motthomasn/K-Line_Logger/Images/5V_Rise_Time_Check.png

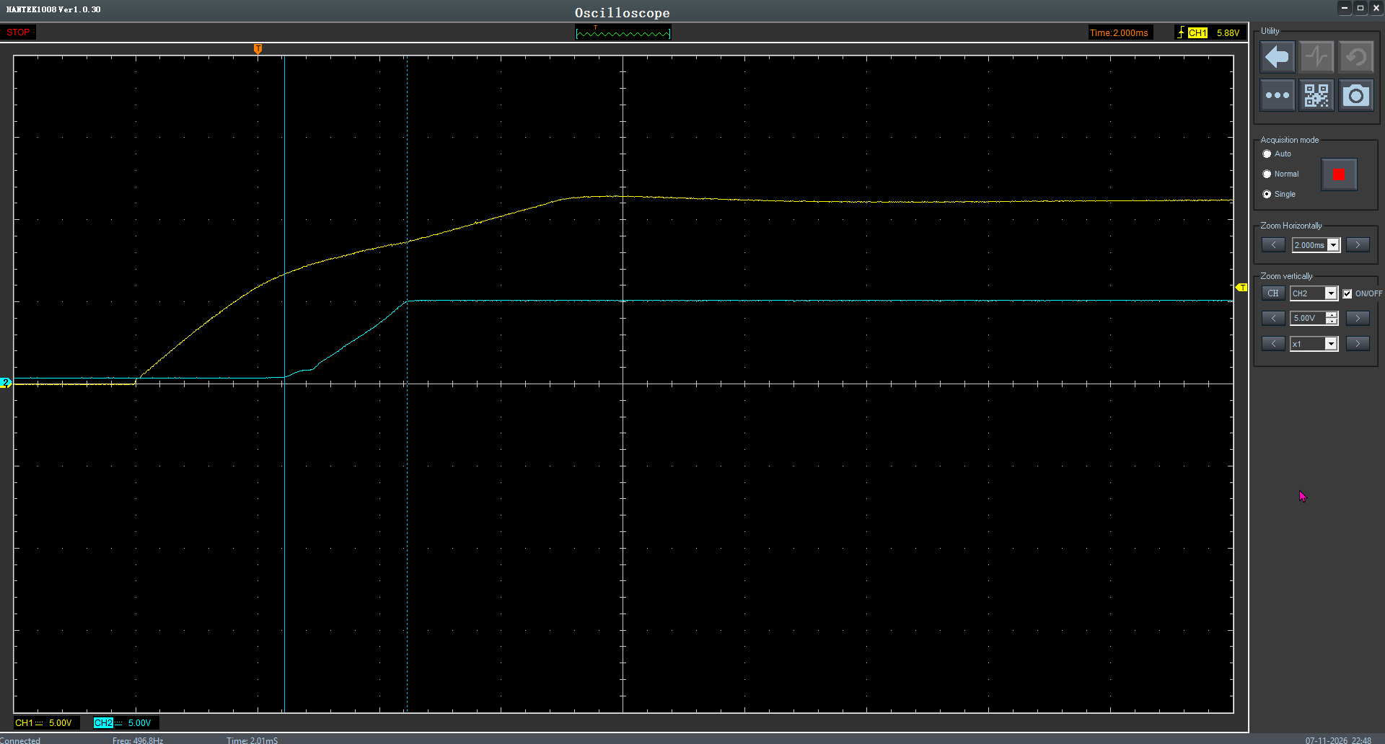
Images/5V_Rise_Time_Check.png
