motthomasn/K-Line_Logger/Images/Bottom_CAD_Image.png

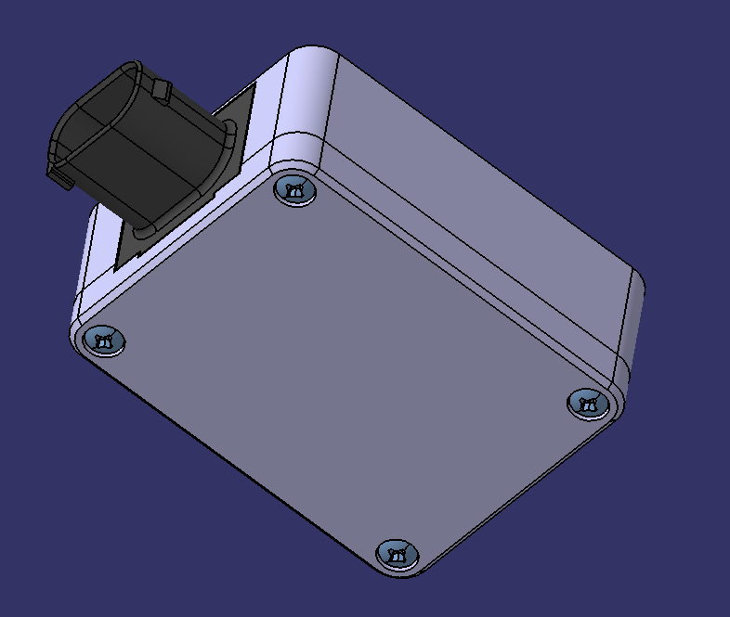
Images/Bottom_CAD_Image.png
