motthomasn/K-Line_Logger/Images/Front_CAD_Image.png

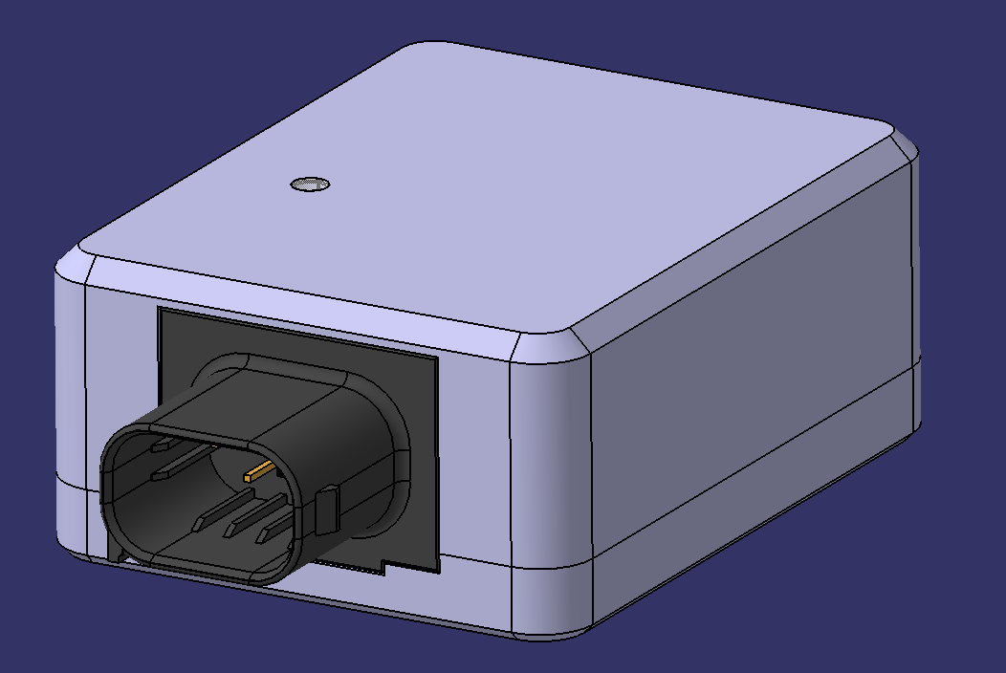
Images/Front_CAD_Image.png
