motthomasn/K-Line_Logger/Images/Logger_Bottom.jpg

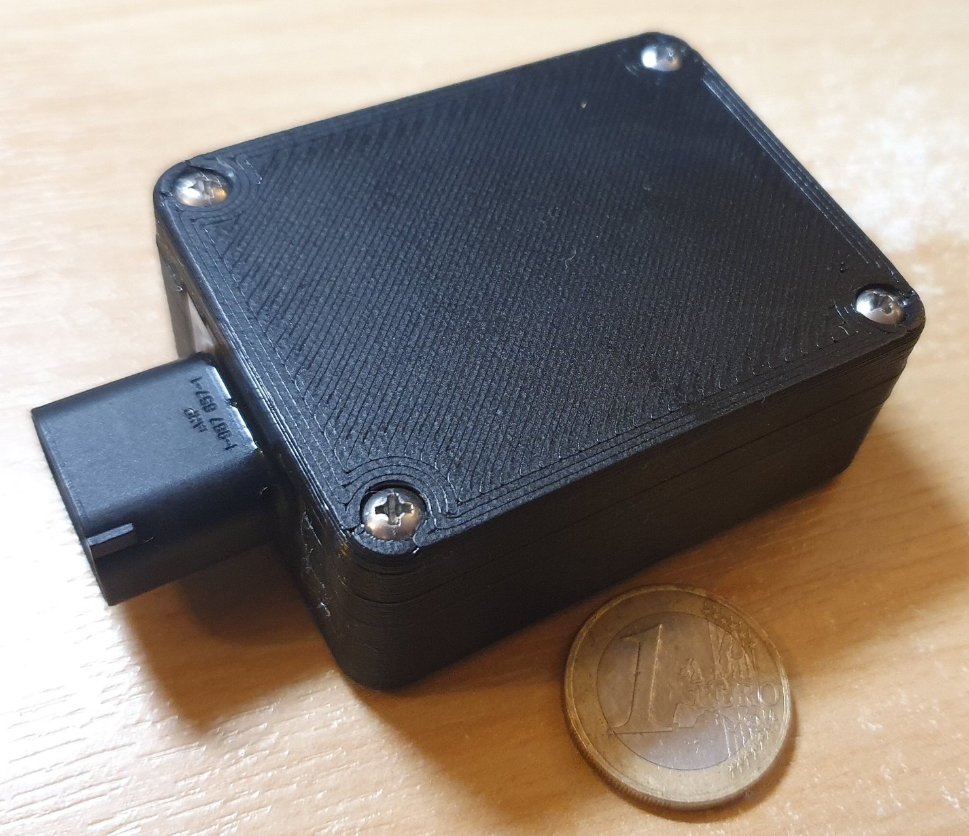
Images/Logger_Bottom.jpg
