motthomasn/K-Line_Logger/Hardware/Kline_SD_Logger_PCB/Kline_SD_Logger_PCB.csv

Reference | Qty | Value | Description | MPN | Farnell SPN | Manufacturer
BT1 | 1 | 3001 | CR1220, CR1216 Coin Cell Retainer | 3001 |  | Keystone
C1 | 1 | 22µF, 25V | SMD Multilayer Ceramic Capacitor, 22 µF, 25 V, 0805 \[2012 Metric], ± 20%, X5R | GRM21BR61E226ME44K | 3790439 | Murata
C2 | 1 | 22,000µF | Supercapacitor, EDLC, 22000 µF, 5.5 V, Radial Leaded, -20%, +80%, 5 mm, 1000 hours @ 70°C | FM0H223ZF | 2777877 | Kemet
C3 | 1 | 5nF, 50V | CAP, MLCC, X7R, 5000PF, 50V, 0805 | 08055C502KAT2A | 3359766 | KYOCERA AVX
D1 | 1 | 40V, 1A | Schottky Rectifier, 40 V, 1 A, Single, SOD-123P, 2 Pins, 560 mV | XBS104P11R-G | 3534762 | TOREX
D2,D3 | 2 | TVS_27V | TVS Diode, SMBJ Series, Unidirectional, 20 V, 32.4 V, DO-214AA (SMB), 2 Pins | SMBJ20A/TR7 | 3104007 | YAGEO
D4 | 1 | G_2.2V_20mA | LED, Low Power, Green, SMD, 1206 (3216 Metric), 20 mA, 2.2 V, 568 nm | KPT-3216SGC | 2099247 | KINGBRIGHT
J1 | 1 | DM3CS-SF | Memory Card Connector, MicroSD, Hinged, 8 Contacts, Copper Alloy, Gold Plated Contacts, DM3 | DM3CS-SF | 1764376 | Hirose
J2 | 1 | TE_1-967657-1 | Rectangular Power Connector, 4 Contacts, MQS, PCB Mount, Through Hole, 3.1 mm, Header | 1-967657-1 | 2798121 | TE Connectivity
R1 | 1 | 3.9K | Thick Film SMD resistor. 3.9K, 1%, 0.13W. 0805 package | CRG0805F3K9 |  | TE Connectivity
R2,R3,R4,R5 | 4 | 523 | Metal Film SMD resistor. 523, 0.1%, 0.13W. 0805 package | ERA6AEB5230V |  | Panasonic
R6 | 1 | 56 | SMD Chip Resistor, 56 ohm, ± 1%, 125 mW, 0805 \[2012 Metric], Thick Film, General Purpose | MCWR08X56R0FTL | 2447689 | MULTICOMP PRO
U1 | 1 | ESP32-C3_SUPERMINI
U2 | 1 | TSR-1-2450 | Switching Regulator, 5VDC Output, 1A | TSR 1-2450 |  | Traco Power
U3 | 1 | L9637 | K-Line I/O Controller Interface IC ISO 9141 Interface | E-L9637D013TR | 3130050 | STMicroelectronics
U4 | 1 | DS3231M | Extremely Accurate I2C-Integrated RTC/TCXO/Crystal SOIC-16
