motthomasn/K-Line_Logger/Hardware/Enclosure/Kline_SD_Logger_Enclosure_Upper.stp

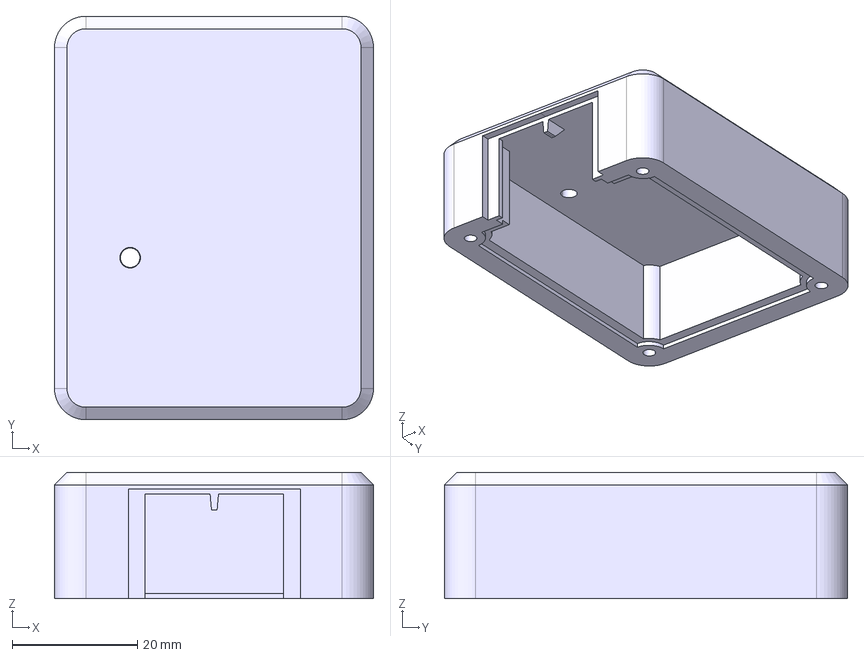
[picture p6: CAD file, 2026-11-08]
Hardware/Enclosure/Kline_SD_Logger_Enclosure_Upper.stp
51.0 x 64.5 x 20.2 mm
