motthomasn/K-Line_Logger/Hardware/Kline_SD_Logger_PCB/Kline_SD_Logger_PCB.step

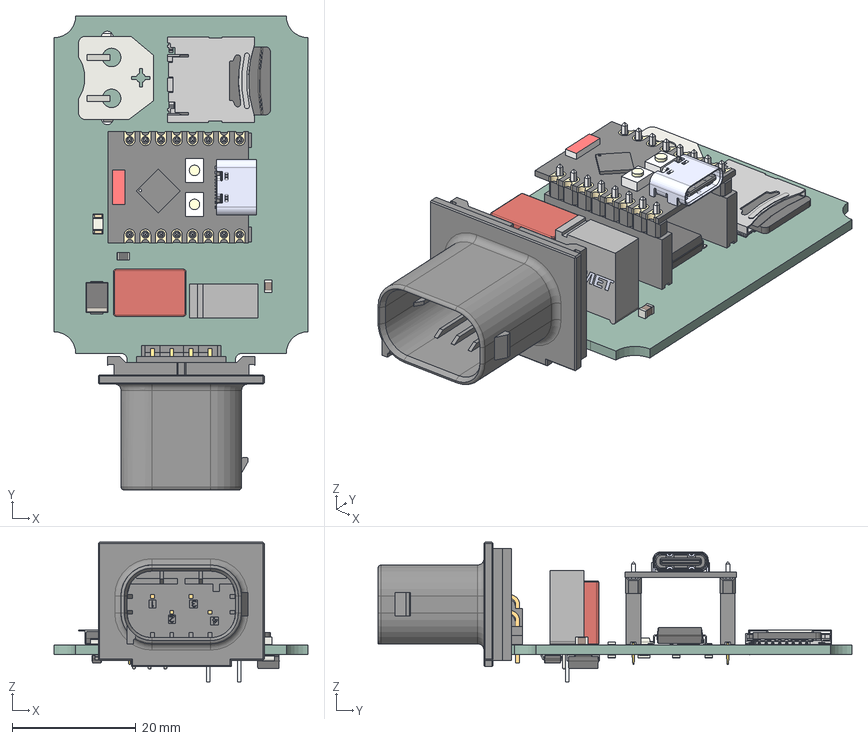
[picture p7: CAD file, 2026-10-16]
Hardware/Kline_SD_Logger_PCB/Kline_SD_Logger_PCB.step
41.0 x 76.6 x 22.6 mm
C_0805_2012Metric x 2
ESP32-C3_SUPERMINI_TH
FM0H223ZF
TE_MQS_4-WAY_1-967657-1
D_SMB x 2
HIROSE_DM3CS-SF
BatteryHolder_Keystone_3001_1x12mm
SOIC-8_3.9x4.9mm_P1.27mm
LED_1206_3216Metric
SOIC-16W_7.5x10.3mm_P1.27mm
Converter_DCDC_TRACO_TSR-1_THT
R_0805_2012Metric x 6
D_SOD-123
Kline_SD_Logger_PCB_PCB
