motthomasn/K-Line_Logger/Hardware/Enclosure/Kline_SD_Logger_Enclosure_Lower.stp

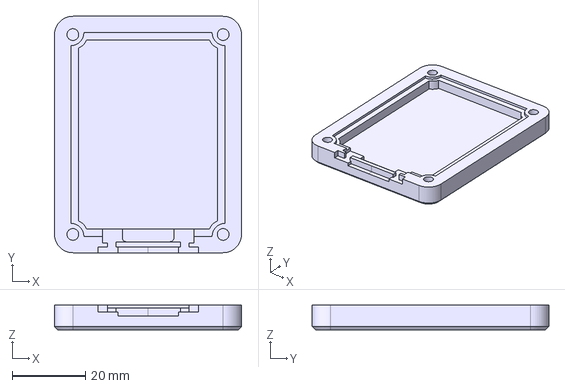
[picture p8: CAD file, 2026-11-08]
Hardware/Enclosure/Kline_SD_Logger_Enclosure_Lower.stp
51.0 x 64.5 x 6.80 mm
