motthomasn/K-Line_Logger/Hardware/Assembly/Adapter_Harness_Suzuki.pdf

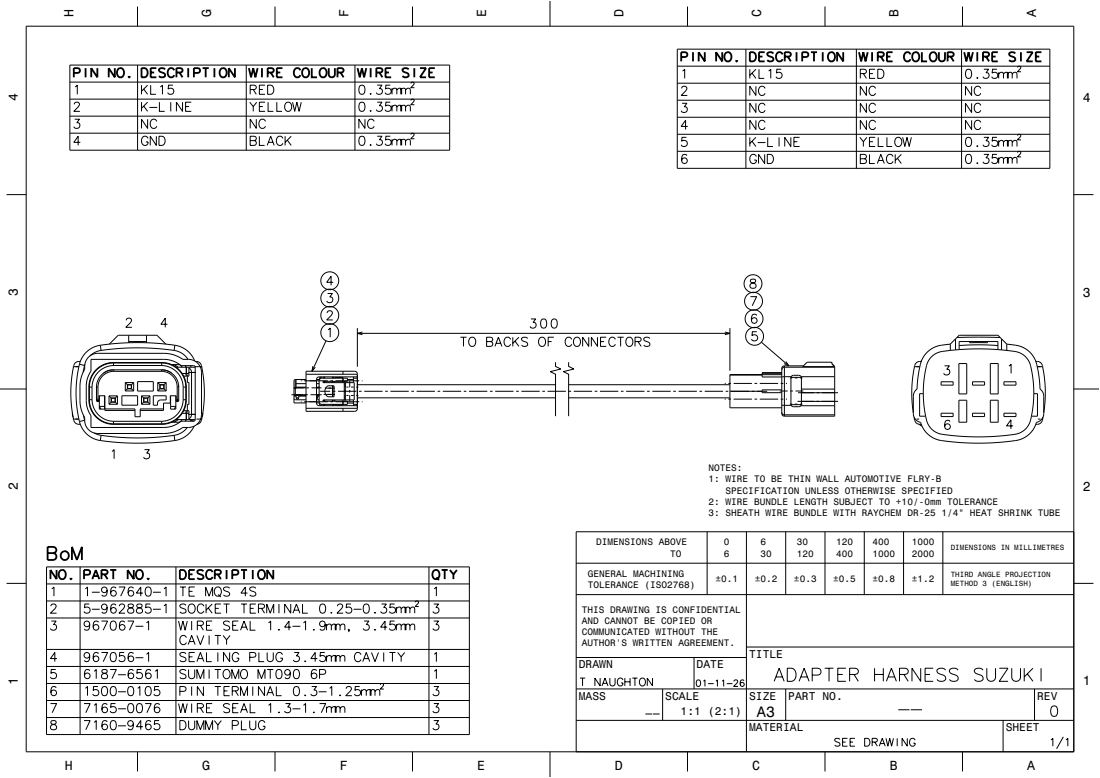
[picture p9: page 1]

NOTES:
1: WIRE TO BE THIN WALL AUTOMOTIVE FLRY-B
SPECIFICATION UNLESS OTHERWISE SPECIFIED
2: WIRE BUNDLE LENGTH SUBJECT TO +10/-0mm TOLERANCE
3: SHEATH WIRE BUNDLE WITH RAYCHEM DR-25 1/4" HEAT SHRINK TUBE

DIMENSIONS ABOVE TO | 0 6 | 6 30 | 30 120 | 120 400 | 400 1000 | 1000 2000 | DIMENSIONS IN MILLIMETRES

GENERAL MACHINING TOLERANCE (ISO2768) | ±0.1 | ±0.2 | ±0.3 | ±0.5 | ±0.8 | ±1.2 | THIRD ANGLE PROJECTION METHOD 3 (ENGLISH)

THIS DRAWING IS CONFIDENTIAL AND CANNOT BE COPIED OR COMMUNICATED WITHOUT THE AUTHOR'S WRITTEN AGREEMENT.

DRAWN | DATE

MASS | SCALE 1:1 (2:1) | SIZE A3 | PART NO. | REV

MATERIAL | SHEET
