motthomasn/K-Line_Logger/Hardware/Assembly/Kline_SD_Logger_Assy.pdf

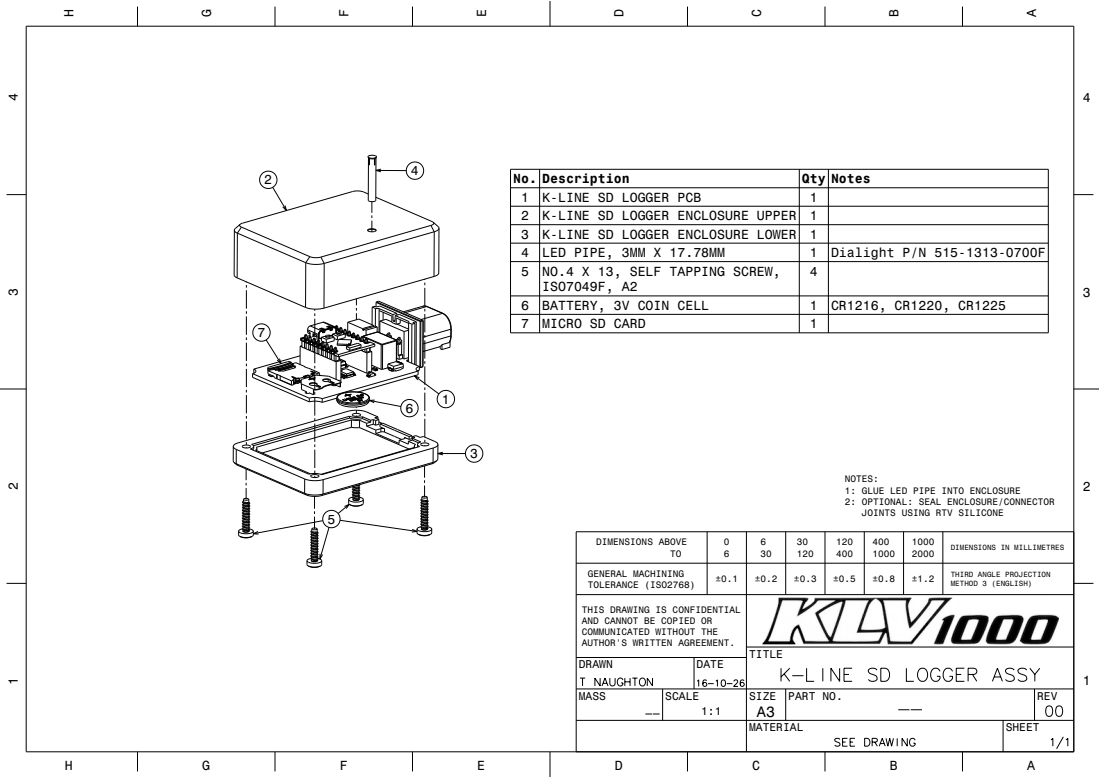
[picture p10: page 1]

No. | Description | Qty | Notes
1 | K-LINE SD LOGGER PCB | 1
2 | K-LINE SD LOGGER ENCLOSURE UPPER | 1
3 | K-LINE SD LOGGER ENCLOSURE LOWER | 1
4 | LED PIPE, 3MM X 17.78MM | 1 | Dialight P/N 515-1313-0700F
5 | NO.4 X 13, SELF TAPPING SCREW, ISO7049F, A2 | 4

6 | BATTERY, 3V COIN CELL | 1 | CR1216, CR1220, CR1225
7 | MICRO SD CARD | 1

NOTES:
1: GLUE LED PIPE INTO ENCLOSURE
2: OPTIONAL: SEAL ENCLOSURE/CONNECTOR
JOINTS USING RTV SILICONE

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

THIS DRAWING IS CONFIDENTIAL AND CANNOT BE COPIED OR COMMUNICATED WITHOUT THE AUTHOR'S WRITTEN AGREEMENT.

DRAWN | DATE

MASS | SCALE 1:1 | SIZE A3 | PART NO. | REV

MATERIAL | SHEET
