motthomasn/K-Line_Logger/Images/Assembled_Board_Bottom.jpg

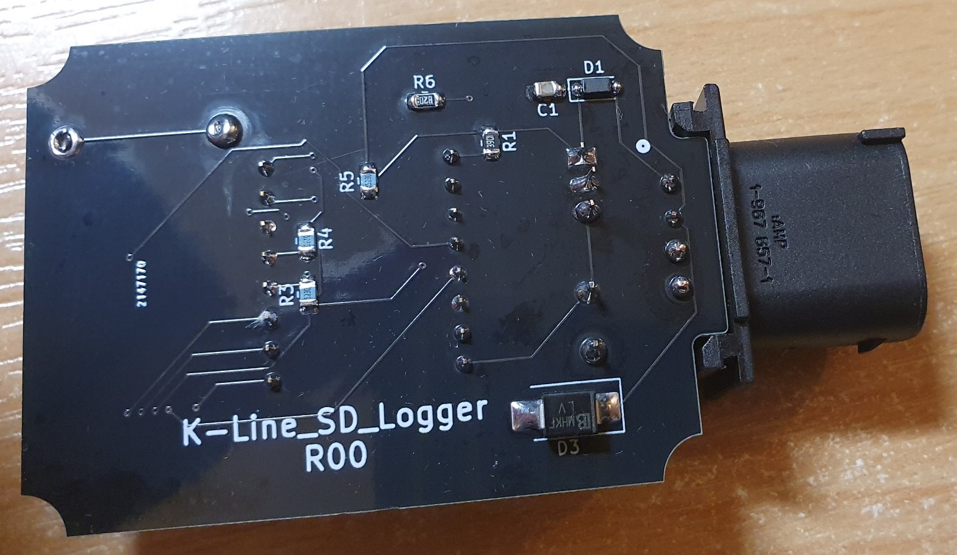
Images/Assembled_Board_Bottom.jpg
