motthomasn/K-Line_Logger/Images/Assembled_Board_CAD_Image.png

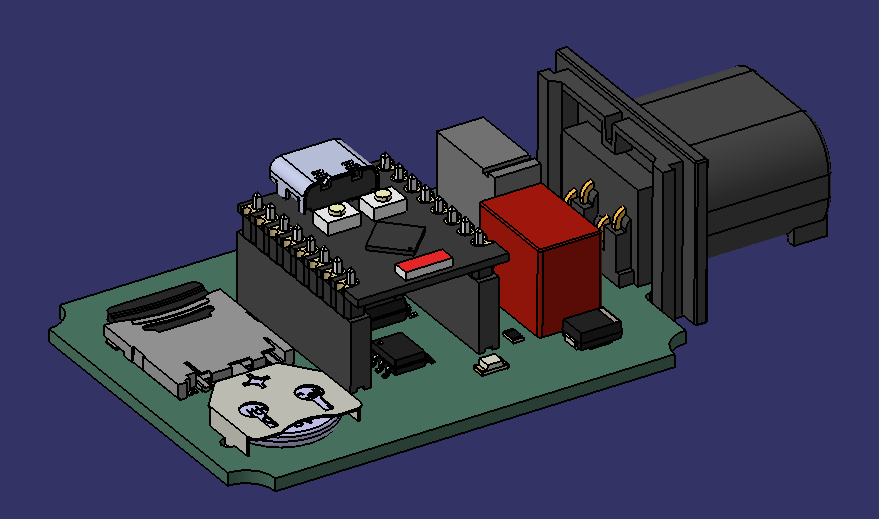
Images/Assembled_Board_CAD_Image.png
