motthomasn/K-Line_Logger/Images/Assembled_Board_Top.jpg

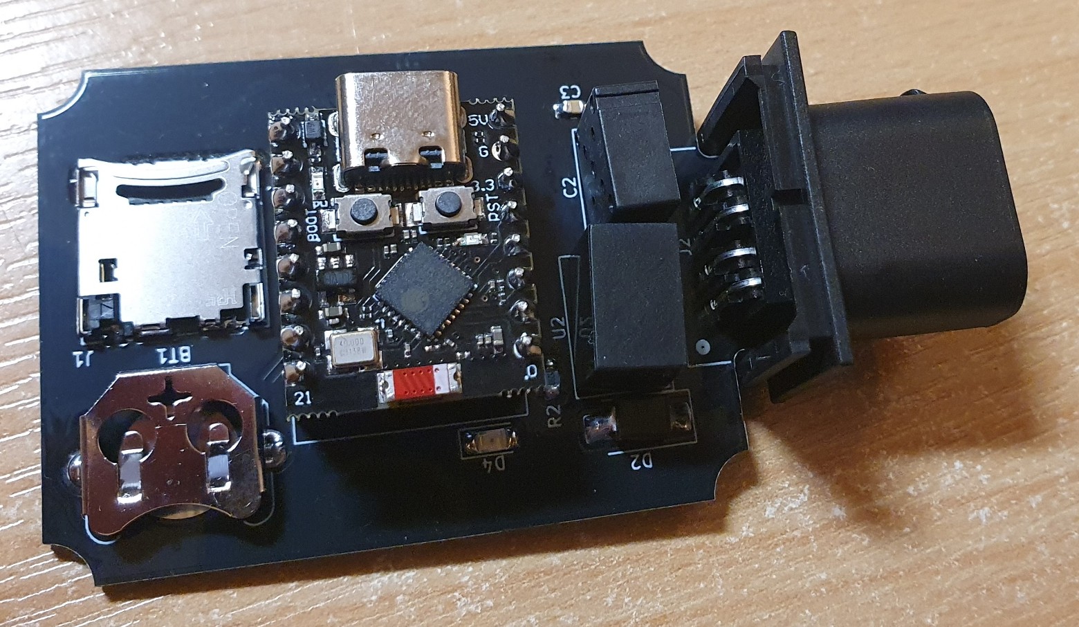
Images/Assembled_Board_Top.jpg
