motthomasn/K-Line_Logger/Images/Exploded_Assembly.png

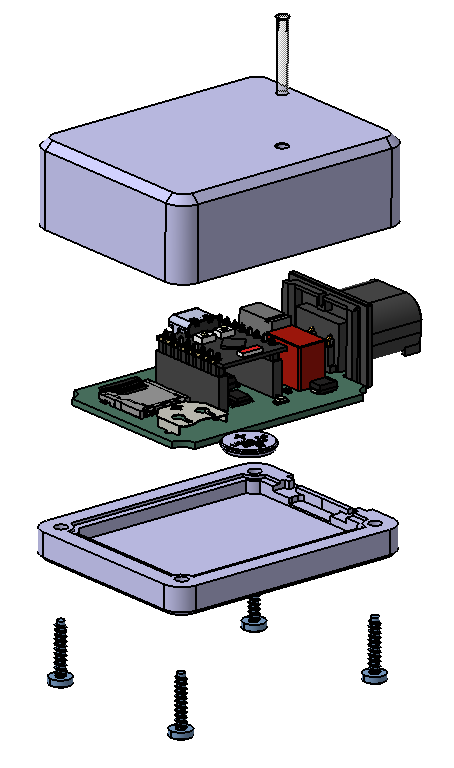
Images/Exploded_Assembly.png
