motthomasn/K-Line_Logger/(commit log)

2026-09-01 Added KiCad PCB design files
    [Kline_SD_Logger_PCB.kicad_pcb, Kline_SD_Logger_PCB.kicad_sch]
2026-09-01 Add initial BoM export
    [Kline_SD_Logger_PCB.csv]
2026-09-02 Add supplier & stock numbers to BoM
    [Kline_SD_Logger_PCB.csv]
2026-09-02 Assign footprints
    [Kline_SD_Logger_PCB.kicad_sch]
2026-10-15 Finalised schematic, updated BoM & placed footprints
    [Kline_SD_Logger_PCB.csv, Kline_SD_Logger_PCB.kicad_pcb, Kline_SD_Logger_PCB.kicad_sch, Kline_SD_Logger_PCB.step]
2026-10-16 Update board edge cuts to fit enclosure
    [Kline_SD_Logger_PCB.kicad_pcb, Kline_SD_Logger_PCB.step]
2026-10-16 Add upper enclosure CAD file
    [Kline_SD_Logger_Enclosure_Upper.stp]
2026-10-16 Update BoM with external components
    [Kline_SD_Logger_PCB.csv]
2026-10-16 Update component placement and track routing
    [Kline_SD_Logger_PCB.kicad_pcb, Kline_SD_Logger_PCB.step]
2026-10-16 Add CAD images
2026-10-16 Add assembly drawing and image
2026-10-16 Remove external components from BoM. Included in assembly drawing
    [Kline_SD_Logger_PCB.csv]
2026-10-16 Add lower enclosure model
    [Kline_SD_Logger_Enclosure_Lower.stp]
2026-10-16 Update upper enclosure model
    [Kline_SD_Logger_Enclosure_Upper.stp]
2026-10-16 Added drawing frame to schematic
    [Kline_SD_Logger_PCB.kicad_sch]
2026-10-16 Add guide lines to assembly drawing
2026-11-02 Update PCB layout
    [Kline_SD_Logger_PCB.kicad_pcb]
2026-11-07 Add STL files to gitignore
2026-11-07 Update board thickness to 1.6mm
    [Kline_SD_Logger_Enclosure_Lower.stp, Kline_SD_Logger_Enclosure_Upper.stp]
2026-11-07 Add images of assembled PCB
2026-11-07 Add images assembled unit & 5V rise time check
2026-11-08 Reduced connector retention flange thickness
    [Kline_SD_Logger_Enclosure_Lower.stp, Kline_SD_Logger_Enclosure_Upper.stp]
2026-11-08 Crop images of assembled unit & add 5V rise time check
